erfankabir01-stack/light-activated-street-light-controller/Screenshot 2026-07-14 164448.png

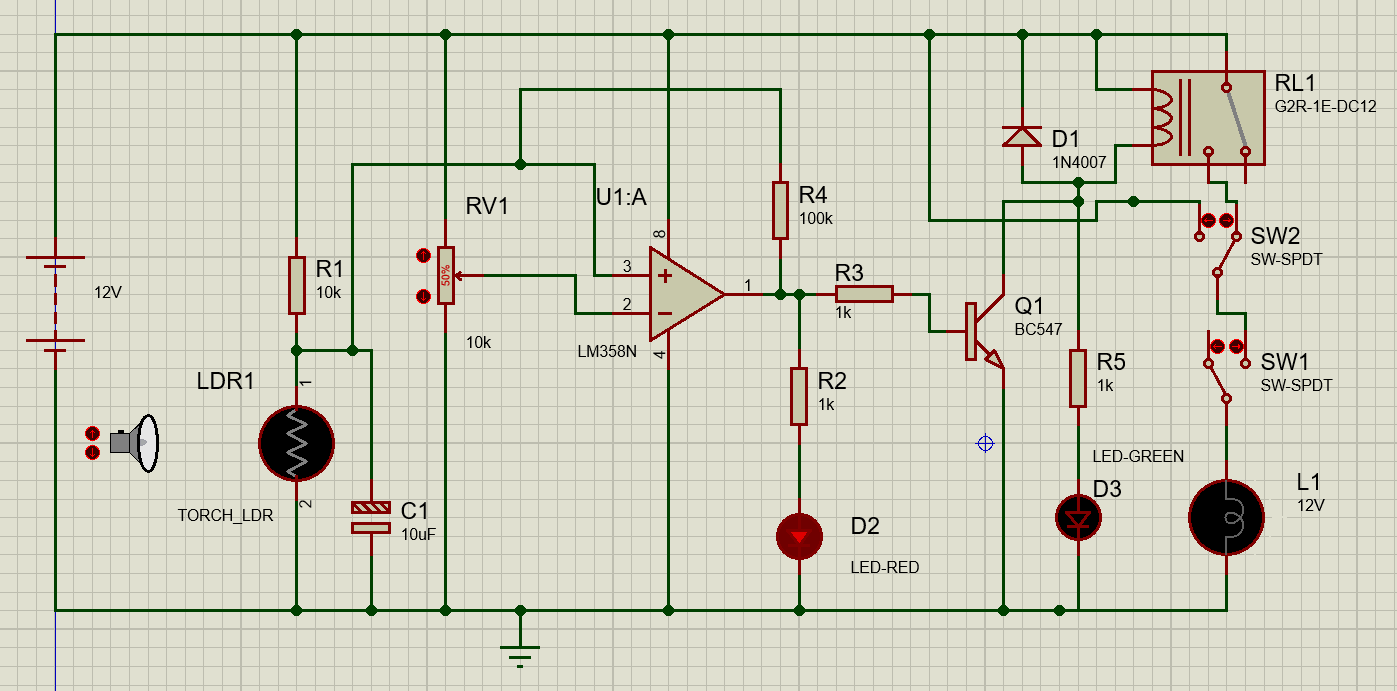
Screenshot 2026-07-14 164448.png
