erfankabir01-stack/light-activated-street-light-controller/(list of files, drawings)

Other design files:
EEE234 Project Sim.pdsprj
